LeonardoPedroso/Arduino-Home-Automation-DomusSapiens/README.md

# DomusSapiens
For a detailed description see ‘./Report/DomusSapiensLeonardoPedroso.pdf’.
