LeonardoPedroso/Arduino-Home-Automation-DomusSapiens/Schematics/DomusSapiens_schem.png

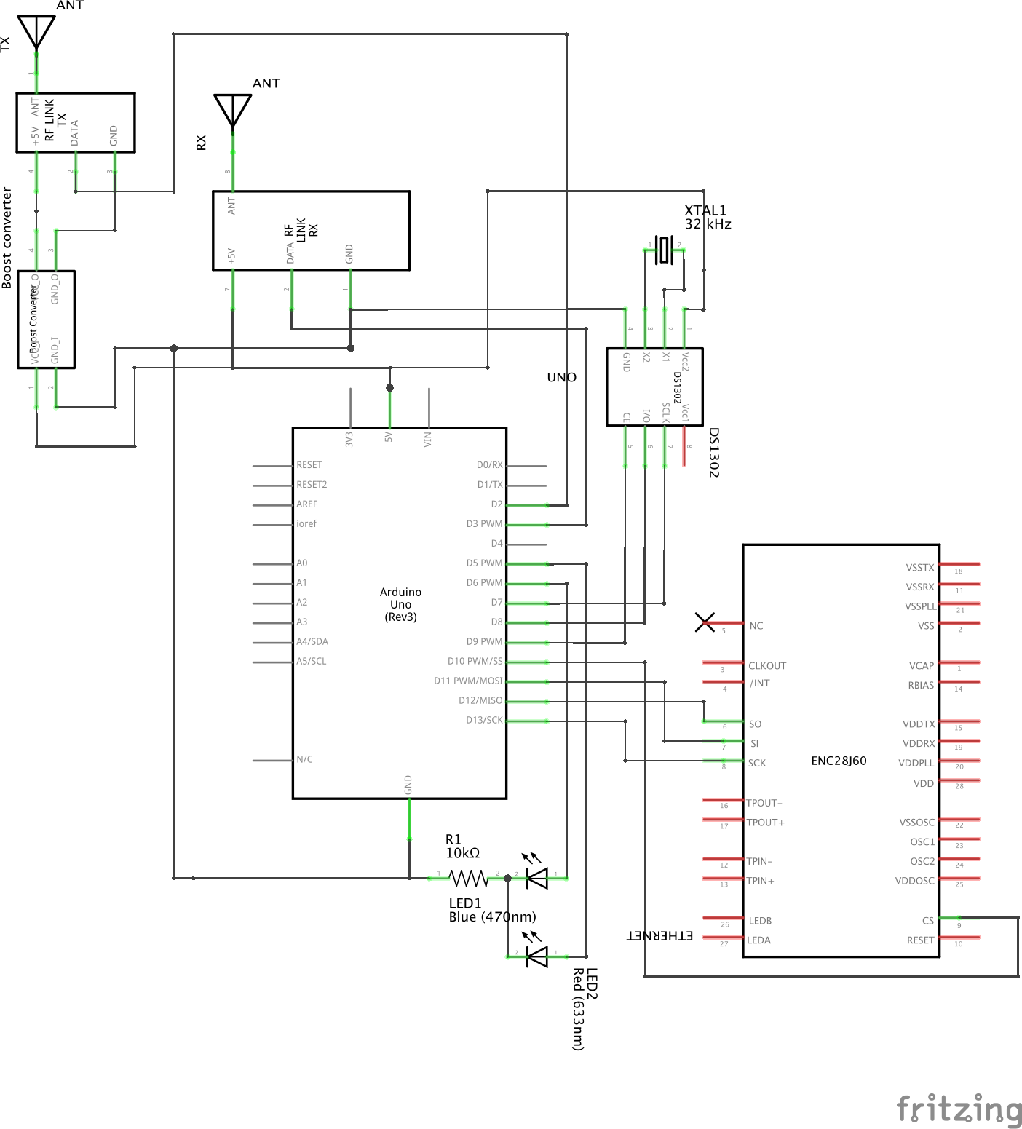
Schematics/DomusSapiens_schem.png
