LeonardoPedroso/Arduino-Home-Automation-DomusSapiens/(list of files, drawings)

Other design files:
Schematics/DomusSapiens.fzz
Schematics/DomusSapiensDevice.fzz
